Taur-Tech/Solar-Powered-Weather-Station/README.md

# Solar-Powered-Weather-Station
Design files for a solar powered weather station.
