Taur-Tech/Solar-Powered-Weather-Station/hardware/Anemometer.pdf

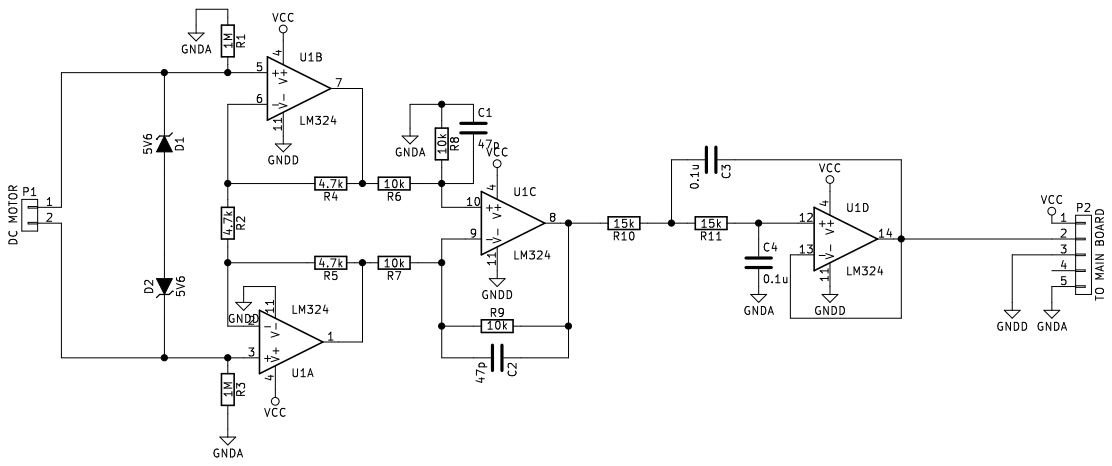
[picture p1: page 1]
