Taur-Tech/Solar-Powered-Weather-Station/hardware/weather station.kicad_pcb

## KiCad design hardware/weather station.kicad_pcb (2018-10-03)

Schematic: weather station.sch, Anemometer

Parts:
C1, C6, C13: 220u; CP_Elec_8x10.5
C2, C5, C8, C9, C10, C11, C12: .1u; C_0805_2012Metric_Pad1.15x1.40mm_HandSolder
C3, C4, C7: 1u; C_0805_2012Metric_Pad1.15x1.40mm_HandSolder
D1, D2, D4, D5: D; D_SMB_Handsoldering
D3: LED; LED_1206_3216Metric_Pad1.42x1.75mm_HandSolder
J1: Conn_01x05; PinHeader_1x05_P2.54mm_Vertical
J2: DIG_EXP; PinHeader_1x06_P2.54mm_Vertical
J3: ICSP; PinHeader_1x05_P2.54mm_Vertical
J4: BAT.; TerminalBlock_4Ucon_1x02_P3.50mm_Horizontal
J5: EXP0; PinHeader_1x04_P2.54mm_Vertical
J6: EXP1; PinHeader_1x04_P2.54mm_Vertical
J7: Wind; PinHeader_1x05_P2.54mm_Vertical
J8: Conn_01x08; PinHeader_1x08_P2.54mm_Vertical
J9: HMC5883L; PinHeader_1x05_P2.54mm_Vertical
J10: Pressure; PinHeader_1x06_P2.54mm_Vertical
J11: Conn_01x04; PinHeader_1x04_P2.54mm_Vertical
J12: Conn_02x07_Odd_Even; PinSocket_2x07_P2.00mm_Vertical
R1: 680R; R_0805_2012Metric_Pad1.15x1.40mm_HandSolder
R2: 10K; R_0805_2012Metric_Pad1.15x1.40mm_HandSolder
R3, R5: 4k7; R_0805_2012Metric_Pad1.15x1.40mm_HandSolder
R4, R8, R9: 100R; R_0805_2012Metric_Pad1.15x1.40mm_HandSolder
R6, R10: 100k; R_0805_2012Metric_Pad1.15x1.40mm_HandSolder
R7: 10k; R_0805_2012Metric_Pad1.15x1.40mm_HandSolder
R11, R12: 1M; R_0805_2012Metric_Pad1.15x1.40mm_HandSolder
R13, R14, R15, R16, R17: 0R; R_0805_2012Metric_Pad1.15x1.40mm_HandSolder
U1: 18650_CHARGER; TP4056
U2: dsPIC30F4011; QFN-44-1EP_8x8mm_P0.65mm_EP6.6x6.6mm
U3: DC-DC(5V); DM06
U4: TLE2426xD; SOIC-8_3.9x4.9mm_P1.27mm
U5, U6: LM2904; TSSOP-8_4.4x3mm_P0.65mm
U7: TLV70033_SOT23-5; SOT-23-5

Connections:
+5V: C5.1, C6.1, C8.1, C9.1, C10.1, C11.1, J2.1, J3.2, J5.1, J6.1, J7.5, R2.2, R3.1, R5.1, R15.2, R16.2, R17.2, U2.7, U2.8, U2.17, U2.28, U2.29, U2.40, U3.4, U4.3, U5.8, U6.8
+BATT: D5.2, J4.1, U1.4, U7.1 (IN)
AN0: R8.2, U2.22
AN1: R9.2, U2.23
CTRL0: R13.2, U2.14
CTRL1: R14.2, U2.12
GND: C1.2, C2.2, C3.2, C4.2, C5.2, C6.2, C7.2, C8.2, C9.2, C10.2, C11.2, C12.2, C13.2, D3.1, J1.4, J1.5, J2.6, J3.3, J4.2, J5.4, J6.4, J7.3, J8.5, J9.2, J10.6, J11.3, J12.1, R7.2, R11.2, R12.2, U1.2, U1.3, U2.6, U2.16, U2.30, U2.31, U2.39, U3.2, U3.3, U4.2, U5.4, U6.4, U7.2 (GND)
LED: R1.2, U2.35
unnamed: C3.1, D4.1, D5.1, U3.1
unnamed: C7.1, U4.8
unnamed: C12.1, C13.1, J8.4, J12.2, U7.5 (OUT)
unnamed: D1.2, J1.1
unnamed: D2.2, J1.2
unnamed: D3.2, R1.1
unnamed: J2.2, U2.42
unnamed: J2.3, U2.37
unnamed: J2.4, U2.41
unnamed: J2.5, U2.38
unnamed: J3.1, R2.1, U2.18
unnamed: J5.2, R11.1, U6.3
unnamed: J5.3, R13.1
unnamed: J6.2, R12.1, U6.5
unnamed: J6.3, R14.1
unnamed: J7.4, R10.1, U5.5
unnamed: J9.1, R15.1
unnamed: J10.1, R16.1
unnamed: J11.4, R17.1
unnamed: R4.1, U5.1, U5.2
unnamed: R4.2, U2.21
unnamed: R6.2, R7.1, U5.3
unnamed: R8.1, U6.1, U6.2
unnamed: R9.1, U6.6, U6.7
PGC: J3.5, J9.4, J10.3, J11.1, R3.2, U2.1
PGD: J3.4, J9.3, J10.2, J11.2, R5.2, U2.44
SOLAR_PANEL: C1.1, C2.1, D1.1, D2.1, D4.2, R6.1, U1.1
VGND: C4.1, J7.1, R10.2, U2.19, U2.20, U4.1
WIFI_BOOT: J8.3, J12.8, U2.43
WIFI_EN: U2.15, U7.3 (EN)
WIFI_READY: J8.1, J12.9, U2.4
WIFI_RESET: J8.6, J12.7, U2.5
WIFI_RX: J8.7, J12.3, U2.3
WIFI_TX: J8.8, J12.4, U2.2
WIND: U2.27, U5.6, U5.7

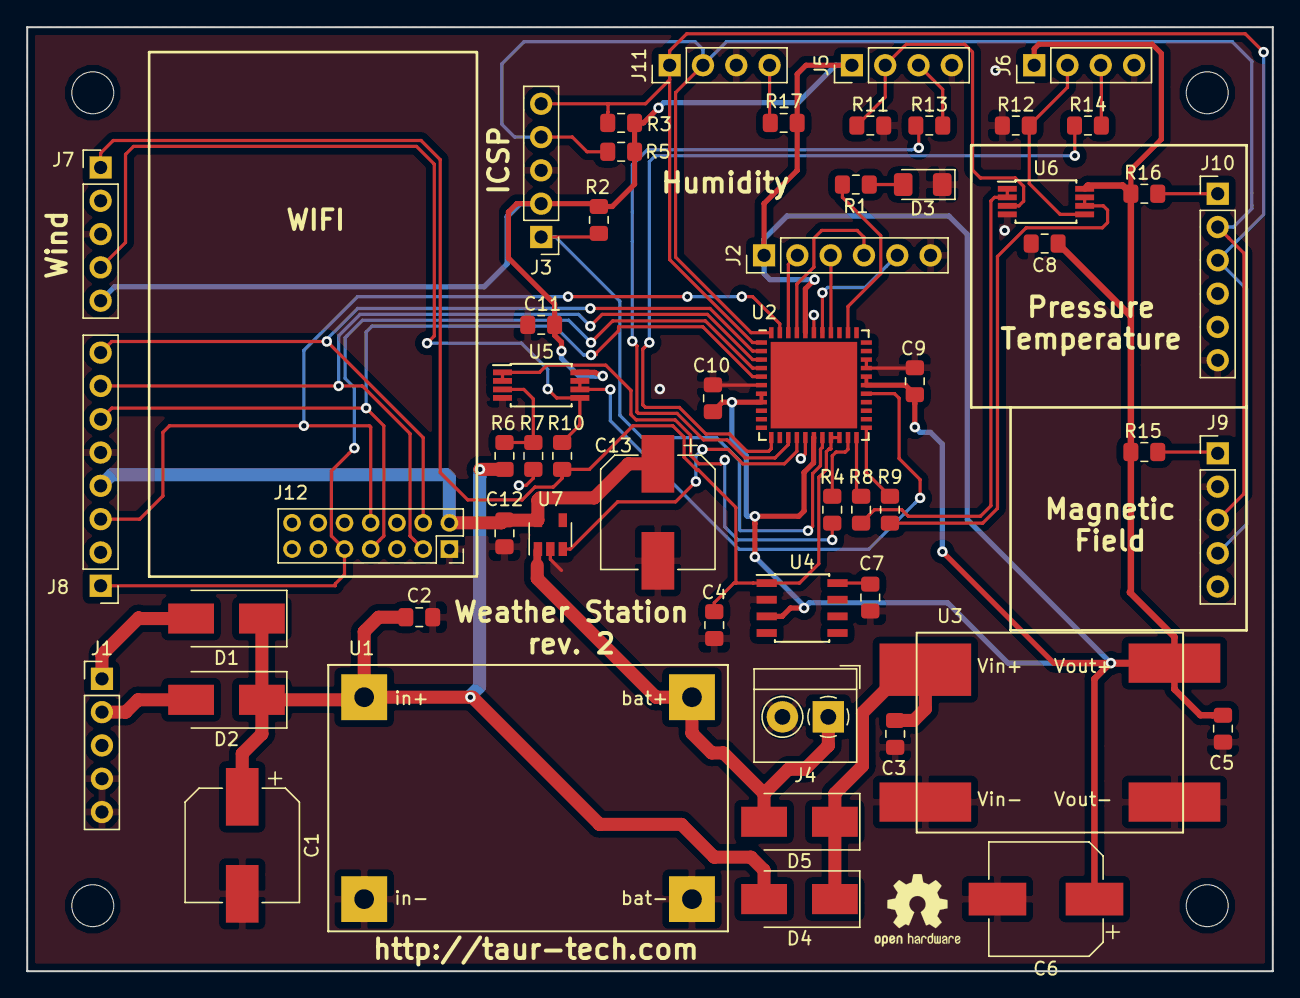
[picture p2: board weather station.kicad_pcb from above]

Board: 2 copper layers, 95.0 x 72.0 mm, 54 parts (0 on the bottom side), 43 nets.
