Taur-Tech/Solar-Powered-Weather-Station/hardware/usr_wifi_setup.png

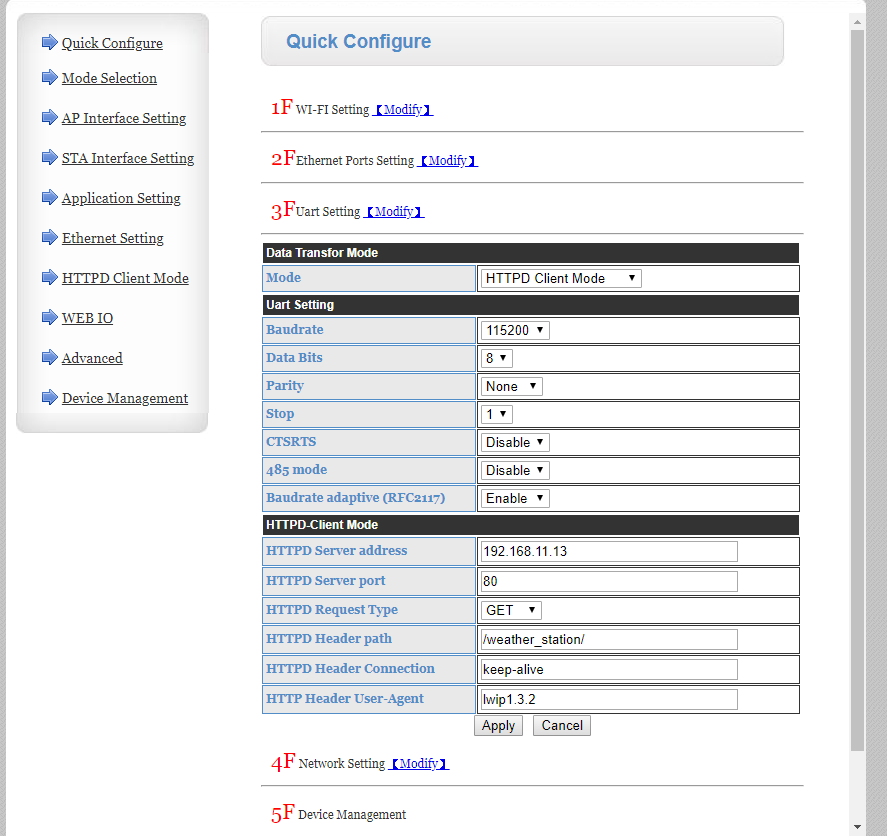
hardware/usr_wifi_setup.png
