Taur-Tech/Solar-Powered-Weather-Station/firmware/src/i2c.c

#include "../inc/i2c.h"

void I2C_Init(void)
{
    I2CCONbits.I2CEN = 0;	
	I2CCONbits.I2CSIDL 	= 0;
	I2CCONbits.IPMIEN 	= 0;
	I2CCONbits.A10M		= 0;
	I2CCONbits.DISSLW 	= 1;
	I2CCONbits.SMEN 	= 0;
    I2CBRG              = setBaudRate();    
    __delay_ms(1);
    I2CCONbits.I2CEN 	= 1;
}

int setBaudRate(){
    return (FCY/I2C_BAUDRATE - FCY/1111111) - 1;
}

int I2C_WriteReg(char dev_addr, char reg_addr, char value)
{
    char wr_dev_addr = dev_addr << 1;
    // Send I2C start condition
	I2CCONbits.SEN = 1;			
	while(I2CCONbits.SEN == 1);
	// Send I2C device address on the bus for write operation
	I2CTRN = wr_dev_addr;			
	while(I2CSTATbits.TRSTAT);			
	if (I2CSTATbits.ACKSTAT)				
	{								
		I2CCONbits.PEN = 1;
		while(I2CCONbits.PEN);			
		return I2C_ERROR;					
	}
    // Send register address on the bus
	I2CTRN = reg_addr;
	while(I2CSTATbits.TRSTAT);
	if (I2CSTATbits.ACKSTAT)
	{
		I2CCONbits.PEN = 1;
		while(I2CCONbits.PEN);
		return I2C_ERROR;
	}
	// Send register value on the bus    
	I2CTRN = value;
	while(I2CSTATbits.TRSTAT);
	if (I2CSTATbits.ACKSTAT)
	{
		I2CCONbits.PEN = 1;
		while(I2CCONbits.PEN);
		return I2C_ERROR;
	}
	/// Send I2C stop condition
	I2CCONbits.PEN = 1;
	while(I2CCONbits.PEN);
	return I2C_OK;
}

int I2C_ReadReg(char dev_addr, char reg_addr, char *value)
{
    char wr_dev_addr = dev_addr << 1;
    char rd_dev_addr = (dev_addr << 1) | 0x01;
    // Send I2C start condition
	I2CCONbits.SEN = 1;	
	while(I2CCONbits.SEN == 1);
	// Send I2C device address on the bus for write operation
	I2CTRN = wr_dev_addr;
	while(I2CSTATbits.TRSTAT);
	if (I2CSTATbits.ACKSTAT)
	{
		I2CCONbits.PEN = 1;
		while(I2CCONbits.PEN);
		return I2C_ERROR;
	}
    // Send I2C register address on the bus 
	I2CTRN = reg_addr;
	while(I2CSTATbits.TRSTAT);
	if (I2CSTATbits.ACKSTAT)
	{	
		I2CCONbits.PEN = 1;
		while(I2CCONbits.PEN);
		return I2C_ERROR;
	}
    // Send I2C restart condition
    I2CCONbits.RSEN = 1;
    while(I2CCONbits.RSEN == 1);	
    // Send I2C device address on the bus for read operation
    I2CTRN = rd_dev_addr;
	while(I2CSTATbits.TRSTAT);
	if (I2CSTATbits.ACKSTAT)
	{
		I2CCONbits.PEN = 1;
		while(I2CCONbits.PEN);
		return I2C_ERROR;	
	}
    // Enable I2C clock for read operation
	I2CCONbits.RCEN = 1;
    while(!I2CSTATbits.RBF);
    // Retrieve value from I2C register
	*value = I2CRCV;	
	// Send I2C stop condition
	I2CCONbits.PEN = 1;
	while(I2CCONbits.PEN);
	return I2C_OK;
}

int I2C_ReadReg16(char dev_addr, char reg_addr, int *value)
{
    char msb, lsb;
    char wr_dev_addr = dev_addr << 1;
    char rd_dev_addr = (dev_addr << 1) | 0x01;
    // Send I2C start condition
	I2CCONbits.SEN = 1;	
	while(I2CCONbits.SEN == 1);
	// Send I2C device address on the bus for write operation
	I2CTRN = wr_dev_addr;
	while(I2CSTATbits.TRSTAT);
	if (I2CSTATbits.ACKSTAT)
	{
		I2CCONbits.PEN = 1;
		while(I2CCONbits.PEN);
		return I2C_ERROR;
	}
    // Send I2C register address on the bus 
	I2CTRN = reg_addr;
	while(I2CSTATbits.TRSTAT);
	if (I2CSTATbits.ACKSTAT)
	{	
		I2CCONbits.PEN = 1;
		while(I2CCONbits.PEN);
		return I2C_ERROR;
	}
    // Send I2C restart condition
    I2CCONbits.RSEN = 1;
    while(I2CCONbits.RSEN == 1);	
    // Send I2C device address on the bus for read operation
    I2CTRN = rd_dev_addr;
	while(I2CSTATbits.TRSTAT);
	if (I2CSTATbits.ACKSTAT)
	{
		I2CCONbits.PEN = 1;
		while(I2CCONbits.PEN);
		return I2C_ERROR;	
	}
    // Enable I2C clock for read operation
	I2CCONbits.RCEN = 1;
    while(!I2CSTATbits.RBF);
    // Retrieve value from I2C register
	msb = I2CRCV;	
    //Initiate ACK and read next byte
    I2CCONbits.ACKEN = 1;
    while(I2CCONbits.ACKEN);
    // Enable I2C clock for read operation
    I2CCONbits.RCEN = 1;
    while(!I2CSTATbits.RBF);
    // Retrieve value from I2C register
	lsb = I2CRCV;    
	// Send I2C stop condition
	I2CCONbits.PEN = 1;
	while(I2CCONbits.PEN);
    *value = msb<<8 | lsb;
	return I2C_OK;
}

int I2C_ReadReg16_Repeat(char dev_addr, char reg_addr, int *value, int repeat_no)
{
    int loop_cnt;
    char msb, lsb;
    char wr_dev_addr = dev_addr << 1;
    char rd_dev_addr = (dev_addr << 1) | 0x01;
    // Send I2C start condition
	I2CCONbits.SEN = 1;	
	while(I2CCONbits.SEN == 1);
	// Send I2C device address on the bus for write operation
	I2CTRN = wr_dev_addr;
	while(I2CSTATbits.TRSTAT);
	if (I2CSTATbits.ACKSTAT)
	{
		I2CCONbits.PEN = 1;
		while(I2CCONbits.PEN);
		return I2C_ERROR;
	}
    // Send I2C register address on the bus 
	I2CTRN = reg_addr;
	while(I2CSTATbits.TRSTAT);
	if (I2CSTATbits.ACKSTAT)
	{	
		I2CCONbits.PEN = 1;
		while(I2CCONbits.PEN);
		return I2C_ERROR;
	}
    // Send I2C restart condition
    I2CCONbits.RSEN = 1;
    while(I2CCONbits.RSEN == 1);	
    // Send I2C device address on the bus for read operation
    I2CTRN = rd_dev_addr;
	while(I2CSTATbits.TRSTAT);
    loop_cnt = 0;
	while (I2CSTATbits.ACKSTAT)
	{
        // If we get NACK more than defined number of tries lets stop 
        // and return error
        if(loop_cnt > repeat_no){
            I2CCONbits.PEN = 1;
            while(I2CCONbits.PEN);
            return I2C_ERROR;
        }
		// Send I2C restart condition
        I2CCONbits.RSEN = 1;
        while(I2CCONbits.RSEN == 1);	
        // Send I2C device address on the bus for read operation
        I2CTRN = rd_dev_addr;
        while(I2CSTATbits.TRSTAT);
        loop_cnt++;
	}
    // Enable I2C clock for read operation
	I2CCONbits.RCEN = 1;
    while(!I2CSTATbits.RBF);
    // Retrieve value from I2C register
	msb = I2CRCV;	
    //Initiate ACK and read next byte
    I2CCONbits.ACKEN = 1;
    while(I2CCONbits.ACKEN);
    // Enable I2C clock for read operation
    I2CCONbits.RCEN = 1;
    while(!I2CSTATbits.RBF);
    // Retrieve value from I2C register
	lsb = I2CRCV;    
	// Send I2C stop condition
	I2CCONbits.PEN = 1;
	while(I2CCONbits.PEN);
    *value = msb<<8 | lsb;
	return I2C_OK;
}
