Taur-Tech/Solar-Powered-Weather-Station/firmware/src/HMC5883L.c

/*
 * File:   HMC5883L.c
 * Author: andrei
 *
 * Created on October 6, 2016, 3:07 PM
 */


#include "xc.h"
#include "../inc/HMC5883L.h"
#include "../inc/i2c.h"
#include "math.h"

float resolution = 0.92;

int two_comp_to_dec(int b){
		if(b & 0x8000){
			b = -1*(0x010000 - b);
        }
		return b;
}

/**
 * Sets a parameter for the sensor such as resolution, data output rate,
 * mode of operation, etc. 
 * @param reg HMC5883L register value where the parameter is stored
 * @param param This is actually an 8 bit mask that allows user to 
 *              change just a certain number of bits in the register
 * @param val  8 bit value holding the parameter value and the rest of the bits
 *              zeros
 * @return      1 is ok, -1 on error
 */
int set_parameter(unsigned char reg, unsigned char param, unsigned char val){
    char tmp;
    if(I2C_ReadReg(HMC5883L, reg, &tmp) == I2C_ERROR){
        return I2C_ERROR;
    }
    tmp &= param;
    tmp |= val;
    if(I2C_WriteReg(HMC5883L, reg, tmp) == I2C_ERROR){
        return I2C_ERROR;
    }
    if(param == RESOLUTION){
        switch(val){
            case 0: resolution=0.73;break;
            case 32: resolution=0.92;break;
            case 64: resolution=1.22;break;
            case 96: resolution=1.52;break;
            case 128: resolution=2.27;break;
            case 160: resolution=2.56;break;
            case 192: resolution=3.03;break;
            case 224: resolution=4.35;break;
            default: break;
        }
    }
    return I2C_OK;
}

int initHMC5883L(void){
    return set_parameter(HMC5883L_MODE, MODE, 0);        
}

/**
 * Retrieve the magnetic field magnitude for x axis in mG
 * @param val Pointer to float variable where we write the result
 * @return 1 if ok, -1 if error
 */
int get_field_x(float *val){
    char msb, lsb;
    int tmp;
    if(I2C_ReadReg(HMC5883L, HMC5883L_X_MSB, &msb) == I2C_ERROR){
        return I2C_ERROR;
    }
    __delay_ms(5);
    if(I2C_ReadReg(HMC5883L, HMC5883L_X_LSB, &lsb) == I2C_ERROR){
        return I2C_ERROR;
    }    
    __delay_ms(5);
    tmp = two_comp_to_dec(msb<<8 | lsb);
    *val = (float)tmp*resolution;
    return I2C_OK;
}

/**
 * Retrieve the magnetic field magnitude for Y axis in mG
 * @param val Pointer to float variable where we write the result
 * @return 1 if ok, -1 if error
 */
int get_field_y(float *val){
    char msb, lsb;
    int tmp;
    if(I2C_ReadReg(HMC5883L, HMC5883L_Y_MSB, &msb) == I2C_ERROR){
        return I2C_ERROR;
    }
    __delay_ms(5);
    if(I2C_ReadReg(HMC5883L, HMC5883L_Y_LSB, &lsb) == I2C_ERROR){
        return I2C_ERROR;
    }    
    __delay_ms(5);
    tmp = two_comp_to_dec(msb<<8 | lsb);
    *val = (float)tmp*resolution;
    return I2C_OK;
}

/**
 * Retrieve the magnetic field magnitude for Z axis in mG
 * @param val Pointer to float variable where we write the result
 * @return 1 if ok, -1 if error
 */
int get_field_z(float *val){
    char msb, lsb;
    int tmp;
    if(I2C_ReadReg(HMC5883L, HMC5883L_Z_MSB, &msb) == I2C_ERROR){
        return I2C_ERROR;
    }
    __delay_ms(5);
    if(I2C_ReadReg(HMC5883L, HMC5883L_Z_LSB, &lsb) == I2C_ERROR){
        return I2C_ERROR;
    }    
    __delay_ms(5);
    tmp = two_comp_to_dec(msb<<8 | lsb);
    *val = (float)tmp*resolution;
    return I2C_OK;
}
