Taur-Tech/Solar-Powered-Weather-Station/firmware/inc/solar_panel.h

/* 
 * File: solar_panel.h
 * Author: Andrei Chelariu  
 * Comments:
 * Revision history: 
 */

#ifndef SOLAR_PANEL_H
#define	SOLAR_PANEL_H

#include <xc.h>  

#ifdef	__cplusplus
extern "C" {
#endif /* __cplusplus */

#define SOLAR_PANEL_CHANNEL     2
#define SOLAR_PANEL_AVG_SIZE    512

#ifdef	__cplusplus
}
#endif /* __cplusplus */

#endif	/* SOLAR_PANEL_H */
