Taur-Tech/Solar-Powered-Weather-Station/(commit log)

2016-10-10 Added HMC5883L, BMP085, I2C and UART functions
2016-12-21 added basic anemometer
    [weather station.kicad_pcb, weather station.sch]
2016-12-23 Anemometer: modify input R for instr amp
    [weather station.sch]
2017-01-03 Add Si7021 humidity sensor driver
2017-01-03 add calibration parameters for anemometer
    [weather station.sch]
2017-02-25 define adc resolution
2018-10-02 WIP: adding HW resources
    [weather station-2018-09-22-22-56-09.sch, weather station.sch]
2018-10-03 pcb layout complete
    [weather station.kicad_pcb]
